captainigloo/Trimix-analyzer/genesis/analyseur_trimix_ppt_fr.pdf

# Analyseur Trimix :

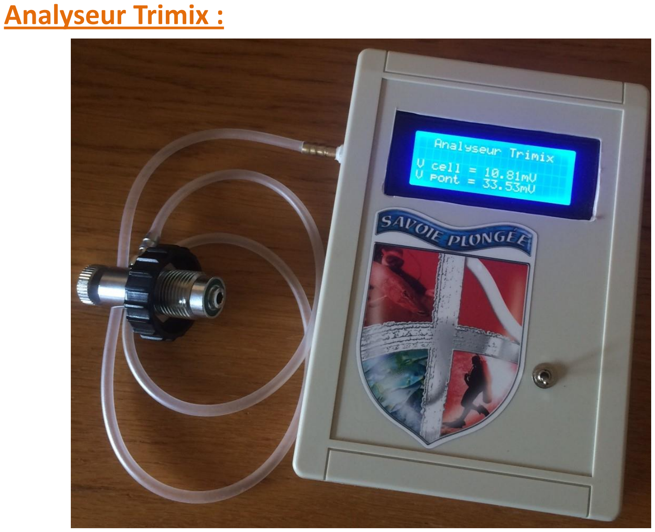
[picture p5: page 1]

# - Utilisation d’une cellule oxygène pour mesurer le taux d’O2 du mélange (30€)

# - Utilisation d’un capteur de conductivité thermique MD62 pour mesurer le taux d’hélium (25€)

- Utilisation d’une carte Arduino pour gérer logiciellement le calibrage des capteurs,

# compenser la non linéarité, afficher le Trimix ou Nitrox analysé et le MOD associé

(3€)

# - Utilisation d’une carte ADS1115 pour mesurer précisément des tensions entre 5mV et 200mV (ce que ne sait pas faire la carte Arduino nativement) (3€)

# - Utilisation d’un générateur de tension LM2596 pour alimenter le pont de Wheatstone du capteur MD62 en 3V (2€)

# - Utilisation d’un limiteur de flux DIN pour doser le flux de gaz circulant dans l’analyseur (49€)

# - Pile 9V remplacée par une batterie LiPo pour plus d’autonomie

# - Le gaz à analyser rentre à l’extrémité d’un bout de tube PVC diamètre 32, passe sur

le capteur MD62, puis sur la cellule O2, et ressort à l’autre extrémité du tube.

# Principe :

# carte Arduino

# les ingrédients :

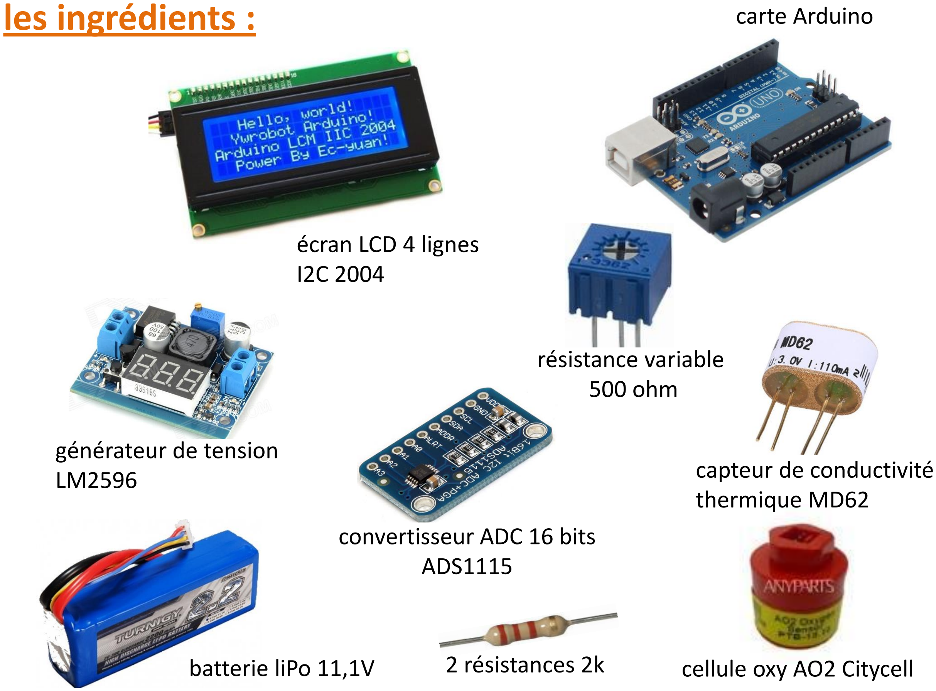
[picture p6: page 3]

batterie liPo 11,1V | cellule oxy AO2 Citycell capteur de conductivité thermique MD62

# générateur de tension

LM2596

# convertisseur ADC 16 bits ADS1115

# écran LCD 4 lignes

I2C 2004

# 2 résistances 2k

# résistance variable 500 ohm

# cablage pont Wheatstone et mesure O2 :

# générateur de tension

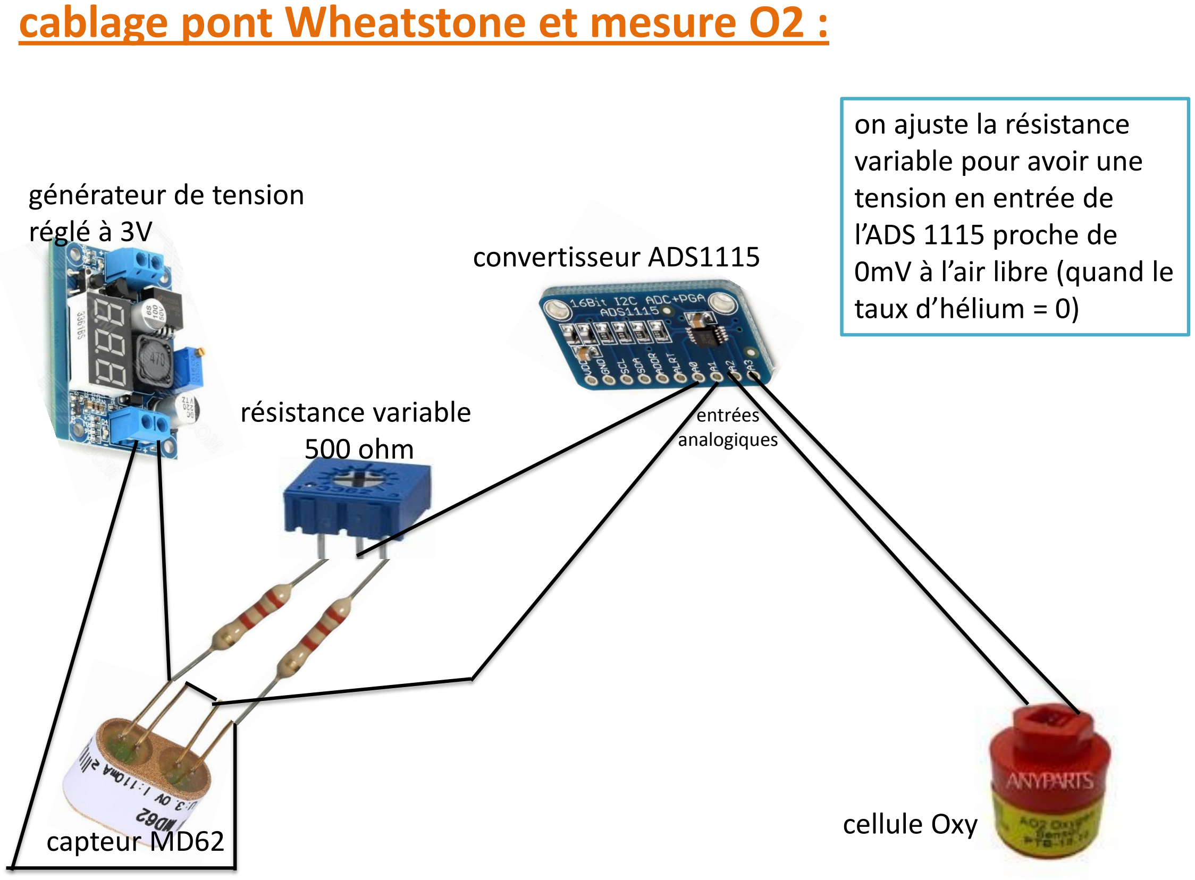
[picture p7: page 4]

# cellule Oxy

# réglé à 3V convertisseur ADS1115

# résistance variable 500 ohm

# capteur MD62

## entrées analogiques

# on ajuste la résistance variable pour avoir une tension en entrée de l’ADS 1115 proche de 0mV à l’air libre (quand le taux d’hélium = 0)

# Datasheet du MD62:

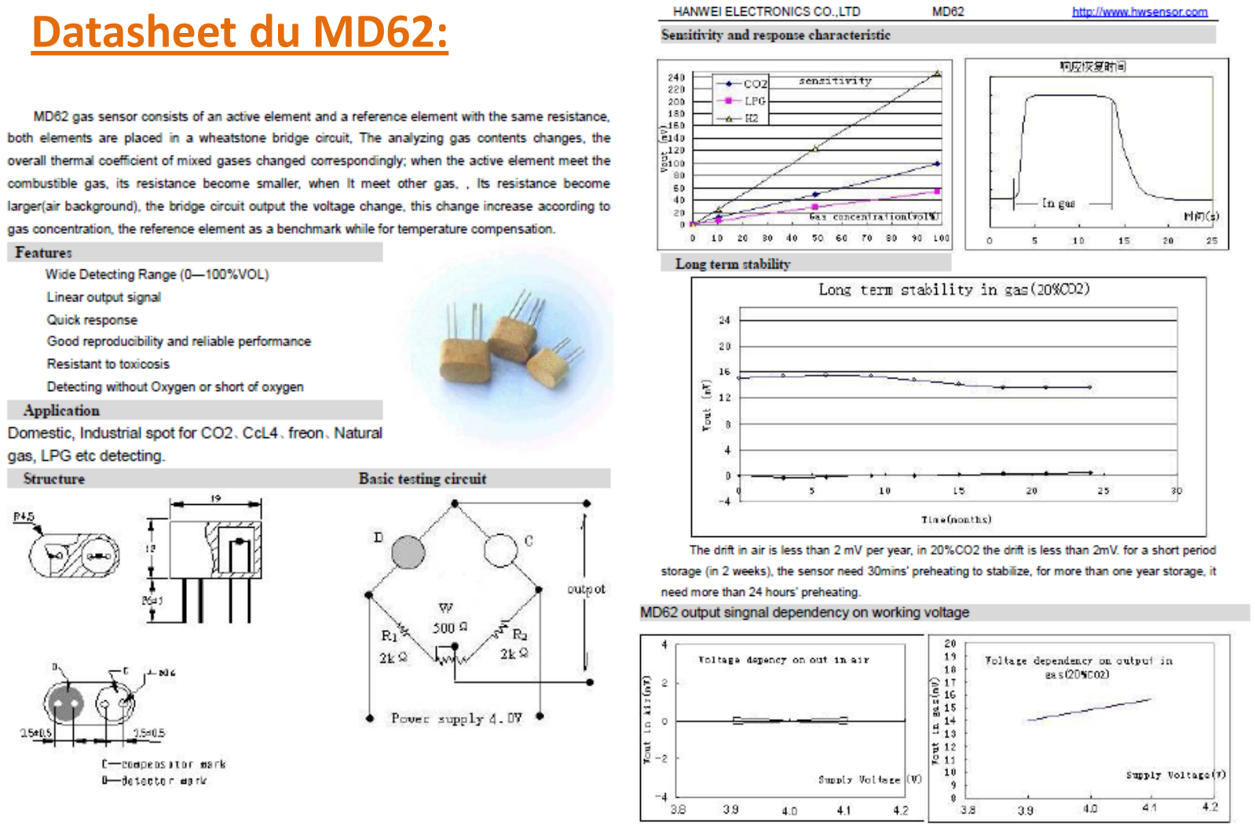
[picture p8: page 5]

# vue d’ensemble :

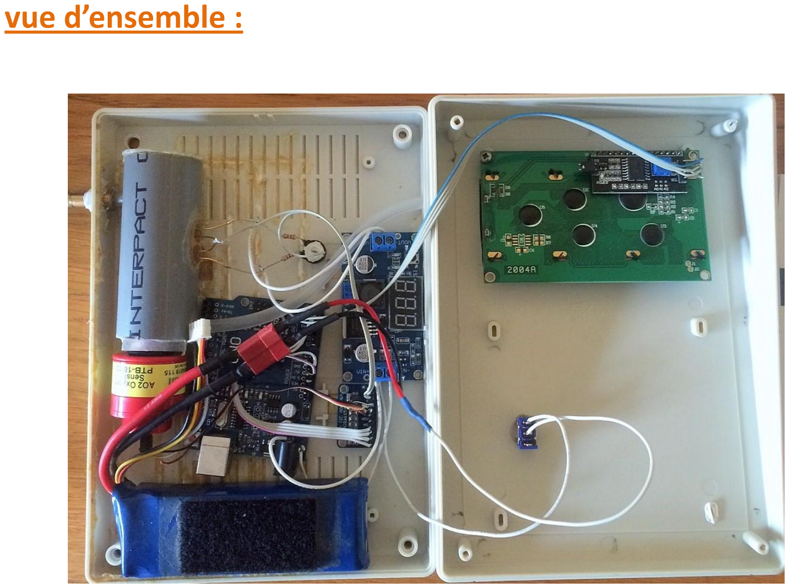
[picture p9: page 6]

# zoom sur le montage :

# carte Arduino

# cellule oxy

# capteur

MD62

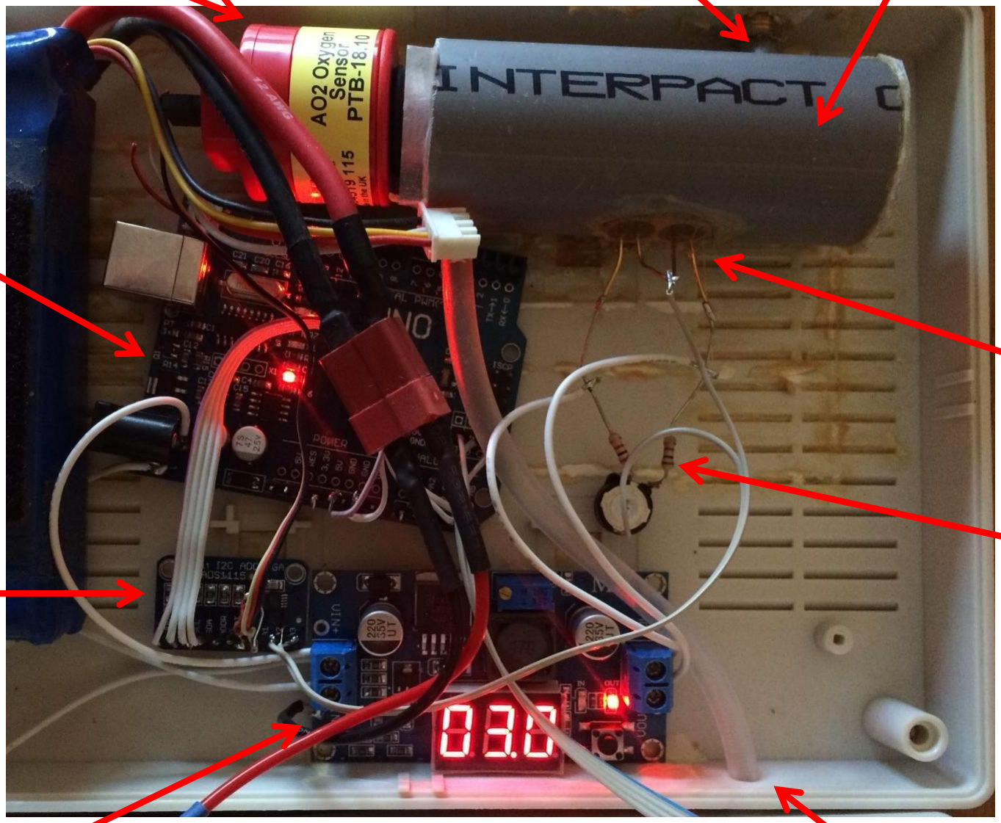
[picture p10: figure]

# générateur de tension réglé à 3V

# convertisseur ADS1115

# résistances

2k

# tube PVC diam 32 entrée gaz

# sortie gaz

# Le programme dans l’Arduino (déclarations) :

#include <Wire.h>

#include <Adafruit_ADS1015.h>

#include <RunningAverage.h>

#include <LiquidCrystal_I2C.h>

LiquidCrystal_I2C lcd(0x27, 20, 4); // set the LCD address to 0x27 for a 20 chars and 4 line display Adafruit_ADS1115 ads; // convertisseur analogique --> digital ADS1115

// variables will change:
float TensionCalib = 0; | // mise a 0 de la tension de calibrage de la cellule
float voltage = 0; | // tension mesuree sur cellule
float wheatstone = 0; | // tension sur pont de wheatsone
float gain = 0.03125; | // gain du convertisseur ADS1115
float calibMD62 = 661.26; | // valeur de la tension du pont avec 100% helium
float WheatCalib = 10; | // mise a 0 de la tension de calibrage du pont à l'air
float CorrFroid = 0 ; | // correction de lecture du fait de lecture a froid (capteur pas assez chaud)
unsigned long time; | // mesure du temps depuis allumage pour ajuster correction
RunningAverage RA0(10); | // moyennage O2 sur 10 valeurs
RunningAverage RA1(10); | // moyennage He sur 10 valeurs

# Le programme dans l’Arduino (setup) :

void setup() {

// initialize serial communication at 9600 bits per second: Serial.begin(9600);

lcd.begin();
lcd.backlight();
lcd.print(" Analyseur Trimix");

ads.setGain(GAIN_FOUR); // 4x gain 1 bit = 0.03125mV ads.begin();

int16_t adc0;
int16_t adc1;

adc0 = ads.readADC_Differential_0_1(); RA0.addValue(adc0);
voltage = abs(RA0.getAverage()*gain);

adc1 = ads.readADC_Differential_2_3(); RA1.addValue(adc1);
wheatstone = RA1.getAverage()*gain;

// affichage de la tension lcd.setCursor(0,2);
lcd.print("V cell = ");
lcd.print(voltage,2);
lcd.print("mV");
lcd.setCursor(0,3);
lcd.print("V pont = ");
lcd.print(wheatstone,2);
lcd.print("mV");
delay(2000);

lcd.clear();
lcd.setCursor(0,1);
lcd.print(" Calib. en cours ...");
lcd.setCursor(0,2);
lcd.print("(utiliser de l'air)");

// determination de la tension moyenne de la cellule à l'air libre int i = 0;
float tensionMoyenne = 0;

for(i = 1; i <10 or (abs (voltage - (tensionMoyenne / (i-1)))) > 0.001; i++) {
adc0 = ads.readADC_Differential_0_1();
RA0.addValue(adc0);
voltage = abs(RA0.getAverage()*gain); tensionMoyenne = tensionMoyenne + voltage; delay(200);
}

lcd.clear();
lcd.setCursor(0,1);
lcd.print(" Calibrage OK");
tensionMoyenne = tensionMoyenne / (i - 1); TensionCalib = tensionMoyenne; lcd.setCursor(0,2);
lcd.print("V calib = ");
lcd.print(TensionCalib,2); lcd.print("mV");

delay(2000);
lcd.clear();
lcd.setCursor(0,0);
lcd.print("Prechauffage du"); lcd.setCursor(0,1);
lcd.print(" capteur Helium..."); delay(500);

while(wheatstone > 10){
adc1 = ads.readADC_Differential_2_3(); RA1.addValue(adc1);
wheatstone = RA1.getAverage()*gain; lcd.setCursor(4,3);
lcd.print("Vpont=");
lcd.print(wheatstone,0);
lcd.print("mV ");
delay(50);
}

lcd.clear();
lcd.setCursor(0,1);
lcd.print(" Capteur He OK"); delay(2000);
lcd.clear();

}

void loop() {
// put your main code here, to run repeatedly:

int16_t adc0;
int16_t adc1;
adc0 = ads.readADC_Differential_0_1();
adc1 = ads.readADC_Differential_2_3();

time = millis(); // temps en ms depuis démarrage programme

RA0.addValue(adc0);
voltage = abs(RA0.getAverage()*gain);

RA1.addValue(adc1);
wheatstone = RA1.getAverage()*gain;

float nitrox = 0;
int MOD = 0; | // valeur de MOD du mélange
int EAD = 0; | // prof equivalente Air pour narcose 30m
float helium = 0;

nitrox = voltage * (20.9 / TensionCalib);
MOD = 10 * ( (160/nitrox) - 1);

lcd.setCursor(0,0);
if (voltage > 1) {
lcd.print("Oxygene = ");
lcd.print(nitrox,1);
lcd.print("% ");
lcd.setCursor(12,2);
lcd.print(" MOD");
lcd.print(MOD);
lcd.print("m");
if (MOD < 100) {
lcd.print(" ");
}
}
else {
lcd.print("Cell O2 HS !!! "); }

lcd.setCursor(0,3);
lcd.print("Vpont=");
lcd.print(wheatstone,0);
lcd.print("mV ");

wheatstone = wheatstone - WheatCalib;

if (time < 480000) { CorrFroid = 1 ; } // correction de la tension lue en fonction du temps de chauffe du capteur
if (time < 360000) { CorrFroid = 2 ; }
if (time < 300000) { CorrFroid = 3 ; }
if (time < 270000) { CorrFroid = 4 ; } if (time < 240000) { CorrFroid = 5 ; } if (time < 210000) { CorrFroid = 6 ; } if (time < 180000) { CorrFroid = 7 ; } if (time < 165000) { CorrFroid = 8 ; } if (time < 150000) { CorrFroid = 9 ; } if (time < 120000) { CorrFroid = 10 ; } if (time < 105000) { CorrFroid = 11 ; } if (time < 90000) { CorrFroid = 12 ; } if (time < 80000) { CorrFroid = 13 ; } if (time < 70000) { CorrFroid = 14 ; } if (time < 60000) { CorrFroid = 15 ; } if (time < 50000) { CorrFroid = 16 ; }
if (time < 40000) { CorrFroid = 17 ; }
if (time < 30000) { CorrFroid = 18 ; }

wheatstone = wheatstone - CorrFroid; // ajustement car capteur pas assez chaud

lcd.setCursor(0,1);
lcd.print("Helium = ");
helium = 100 * wheatstone / calibMD62;
if (helium > 50) {
helium = helium * (1 + (helium - 50) * 0.4 / 100); }
if (helium > 2) {
lcd.print(helium,1);
lcd.print("% ");
}
else {
helium = 0;
lcd.print("0% ");
}

# Le programme dans l’Arduino (loop) :

lcd.setCursor(0,2);
if (helium > 0) {
lcd.print("Trimix ");
lcd.print(nitrox,0);
lcd.print("/");
lcd.print(helium,0);
lcd.print(" ");
lcd.setCursor(12,3);
lcd.print(" EAD");
EAD = 10 * ( 100 * 3.2 / (100 - helium - nitrox) -1 ); lcd.print(EAD);
lcd.print("m");
if (EAD < 100) {
lcd.print(" ");
}
}
else {
lcd.print("Nitrox ");
lcd.print(nitrox,0);
lcd.print(" ");
lcd.setCursor(12,3);
lcd.print(" ");
}
}

# Le programme dans l’Arduino (loop) :

- Carte Arduino Uno : ici (http://fr.aliexpress.com/item/UNO-R3-CH340G-ATmega328P-compatible-for-Arduino-UNO-R3/32523366108.html)
- Ecran LCD 2004 I2C : ici (http://fr.aliexpress.com/item/Free-shipping-LCD-module-Blue-screen-IIC-I2C-2004-5V-20X4-LCD-board-provides-library-files/1873368596.html)
- Carte ADS1115 : ici (http://fr.aliexpress.com/item/ADS1115-ADC-ultra-compact-16-precision-ADC-module-development-board/32313388618.html)
- Générateur de tension LM2596 : ici (http://fr.aliexpress.com/item/LM2596-LM2596S-LED-Voltmeter-ADJ-DC-DC-Step-down-Step-Down-Adjustable-Power-Supply-Module-With/32354870007.html)
- Capteur MD62 : ici (http://fr.aliexpress.com/item/Free-shipping-MD62-heat-conduction-genuine-carbon-dioxide-sensor-CO2-sensor-element/1213772883.html)
- Cellule oxy : ici (http://fr.aliexpress.com/item/City-sensor-ao2-ptb-18-10-oxygen-sensor/1258183473.html?recommendVersion=1)
- Batterie LiPo 11,1V : ici (http://fr.aliexpress.com/item/Lion-Power-Lipo-Lithium-Polymer-11-1v-1200mah-25C-35C-3S-Battery-LiPoli-11-1V-1200mAh/1855127702.html)
- le boitier : ici (http://fr.aliexpress.com/item/Free-shipping-abs-plastic-enclosure-electronic-junction-box-Plastic-electronics-project-box-200-145-63mm/1921519088.html)
- Limiteur de flux : ici (http://www.innodive.com/store/analyseurs-o2-et-he-48/reducteur-de-flux-921.html)

# Les éléments à acheter :
