captainigloo/Trimix-analyzer/images/ao2-oxygen-sensor.jpg

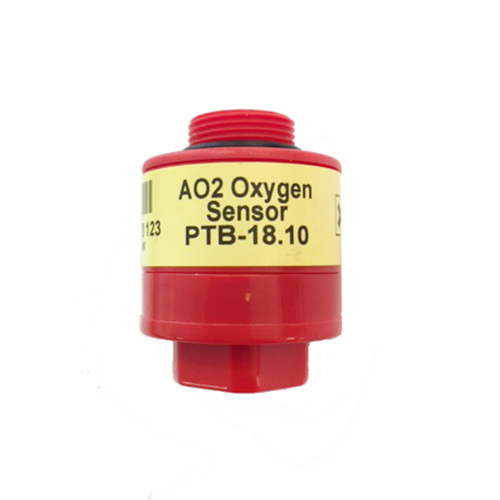
images/ao2-oxygen-sensor.jpg
