captainigloo/Trimix-analyzer/images/deco-mix-sticker.jpg

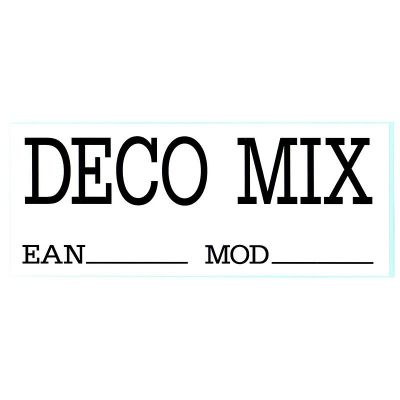
images/deco-mix-sticker.jpg
