captainigloo/Trimix-analyzer/images/Flow-reducer-DIN-5_8.jpg

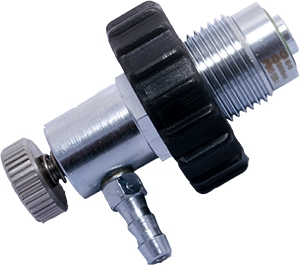
images/Flow-reducer-DIN-5_8.jpg
