captainigloo/Trimix-analyzer/images/MD62.jpg

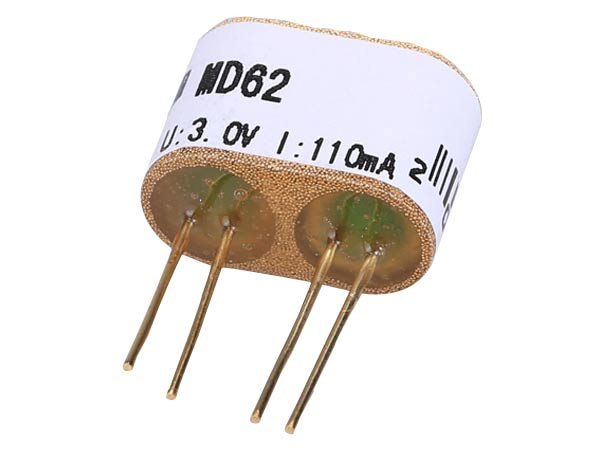
images/MD62.jpg
